HarlinFrancisco/Harlin_Francisco_Electiva_2026_C1/PLC nizao/Proceso de diseño del PLC/Croquis 2.0.jpeg

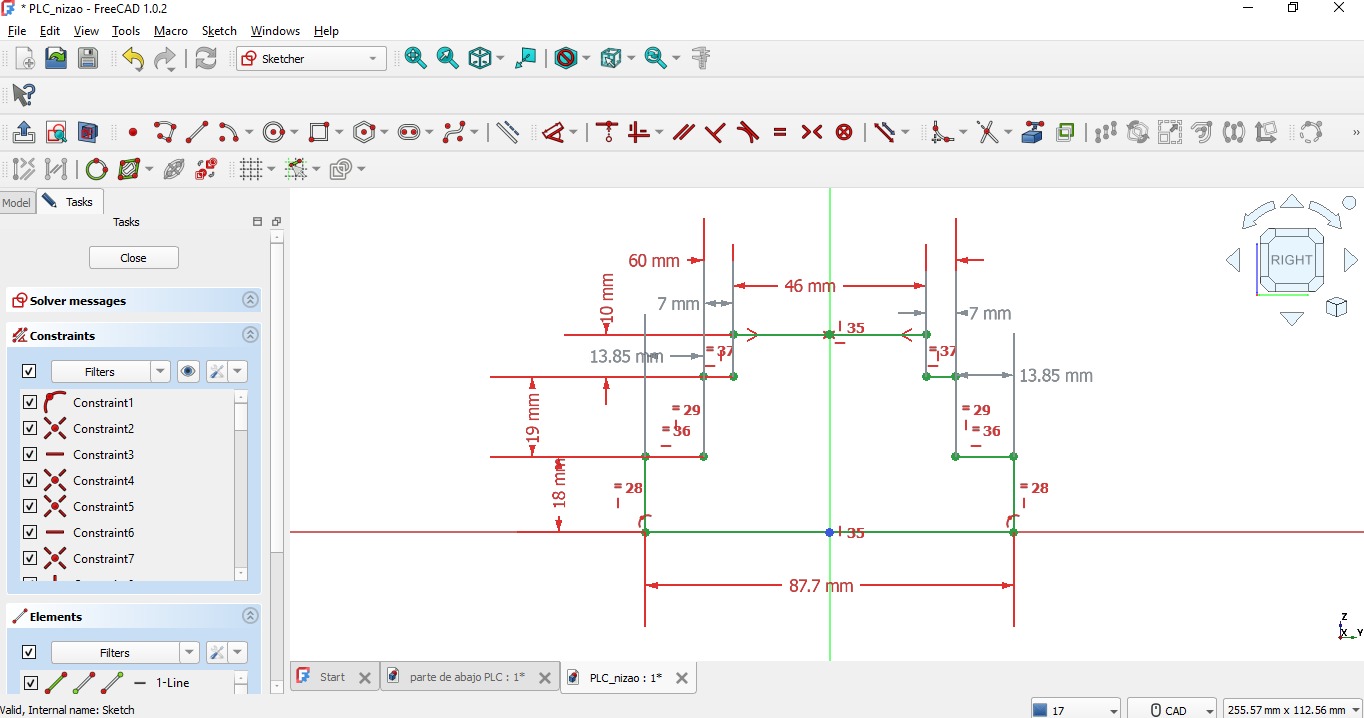
PLC nizao/Proceso de diseño del PLC/Croquis 2.0.jpeg
