HarlinFrancisco/Harlin_Francisco_Electiva_2026_C1/PLC nizao/Proceso de diseño del PLC/Croquis parte 3.jpeg

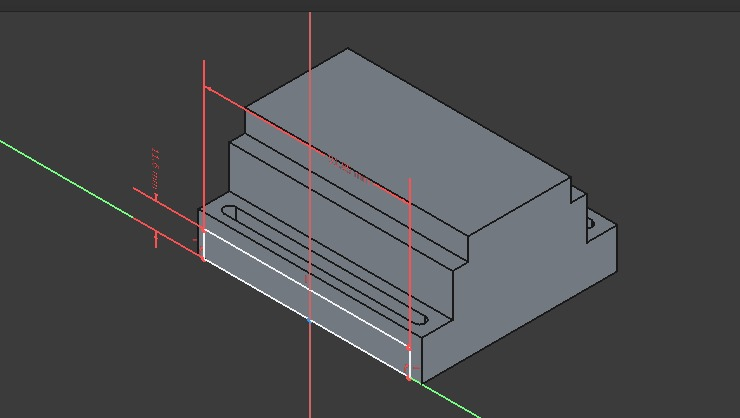
PLC nizao/Proceso de diseño del PLC/Croquis parte 3.jpeg
