HarlinFrancisco/Harlin_Francisco_Electiva_2026_C1/PLC nizao/Proceso de diseño del PLC/Tapa inferior terminada 2.jpeg

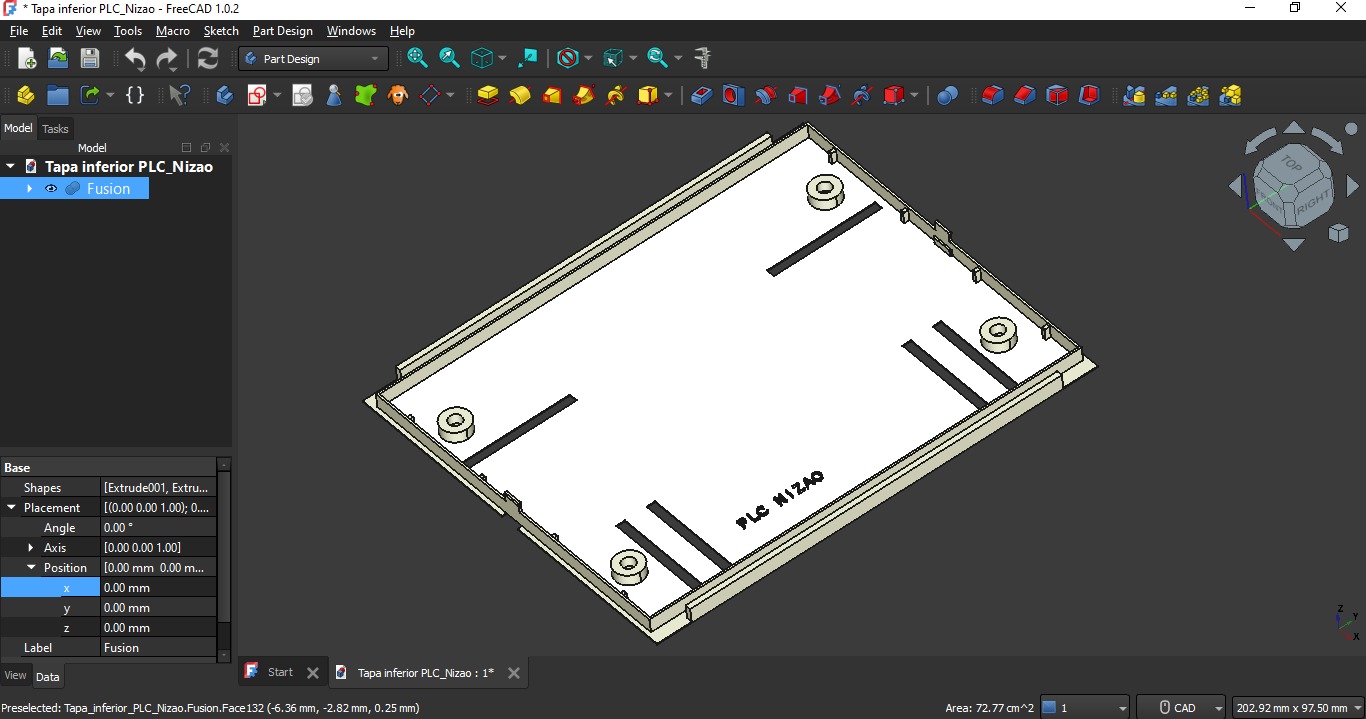
PLC nizao/Proceso de diseño del PLC/Tapa inferior terminada 2.jpeg
