HarlinFrancisco/Harlin_Francisco_Electiva_2026_C1/PLC nizao/Proceso de diseño del PLC/Tapa superior grabado de nombre.jpeg

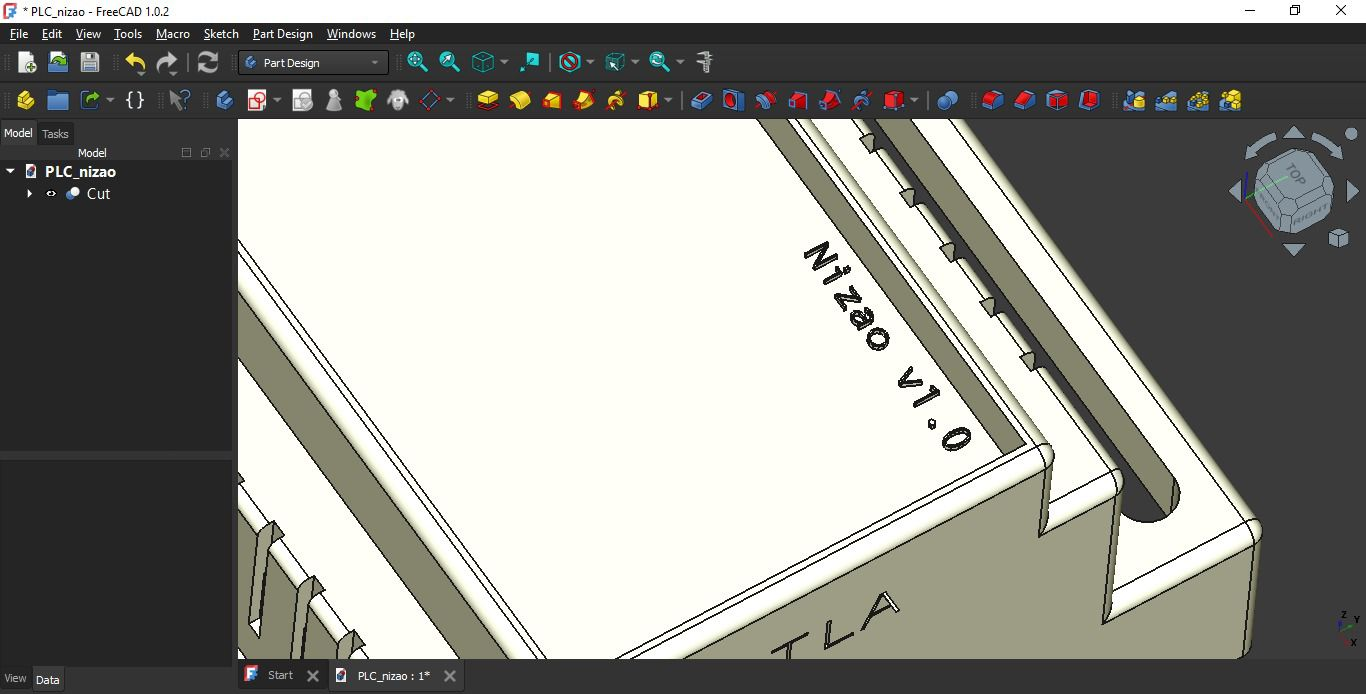
PLC nizao/Proceso de diseño del PLC/Tapa superior grabado de nombre.jpeg
