HarlinFrancisco/Harlin_Francisco_Electiva_2026_C1/PLC nizao/Proceso de diseño del PLC/Tapa superior terminada.jpeg

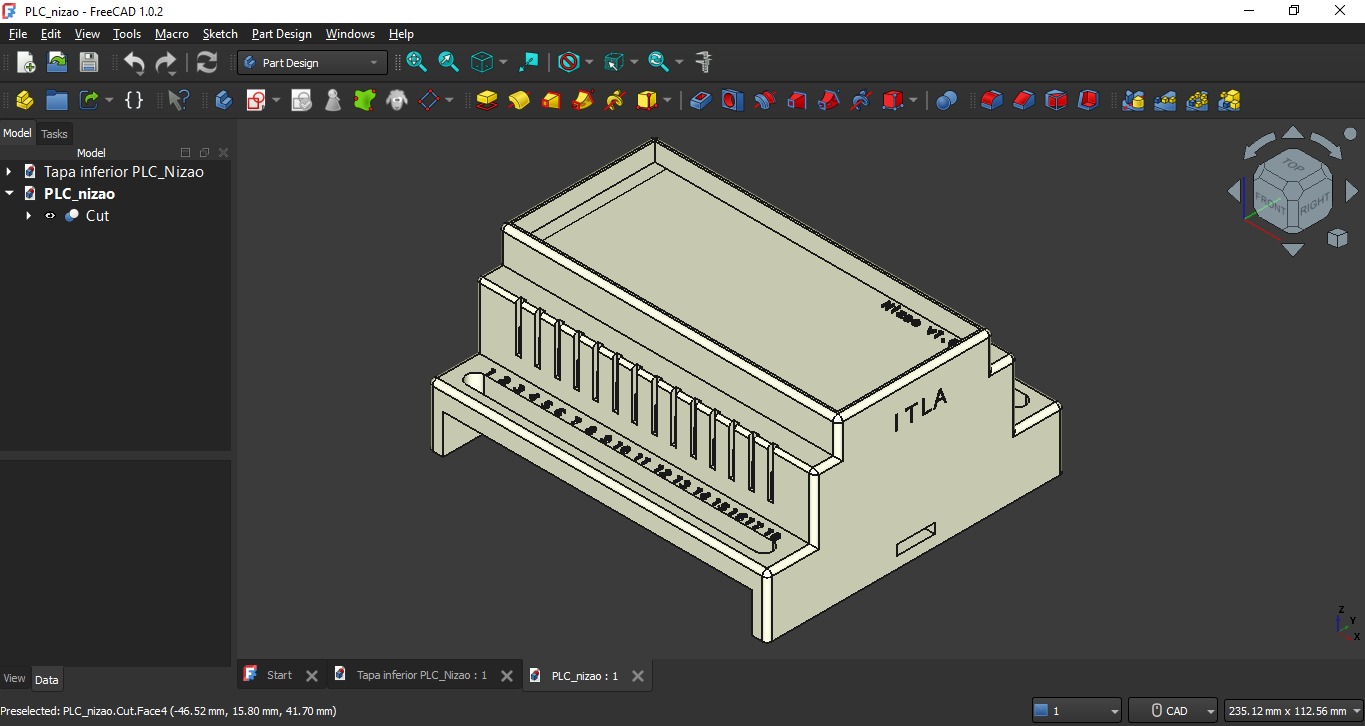
PLC nizao/Proceso de diseño del PLC/Tapa superior terminada.jpeg
