HarlinFrancisco/Harlin_Francisco_Electiva_2026_C1/PLC nizao/Resumenes/Resumen MBSE/MBSE ejemplo.jpg

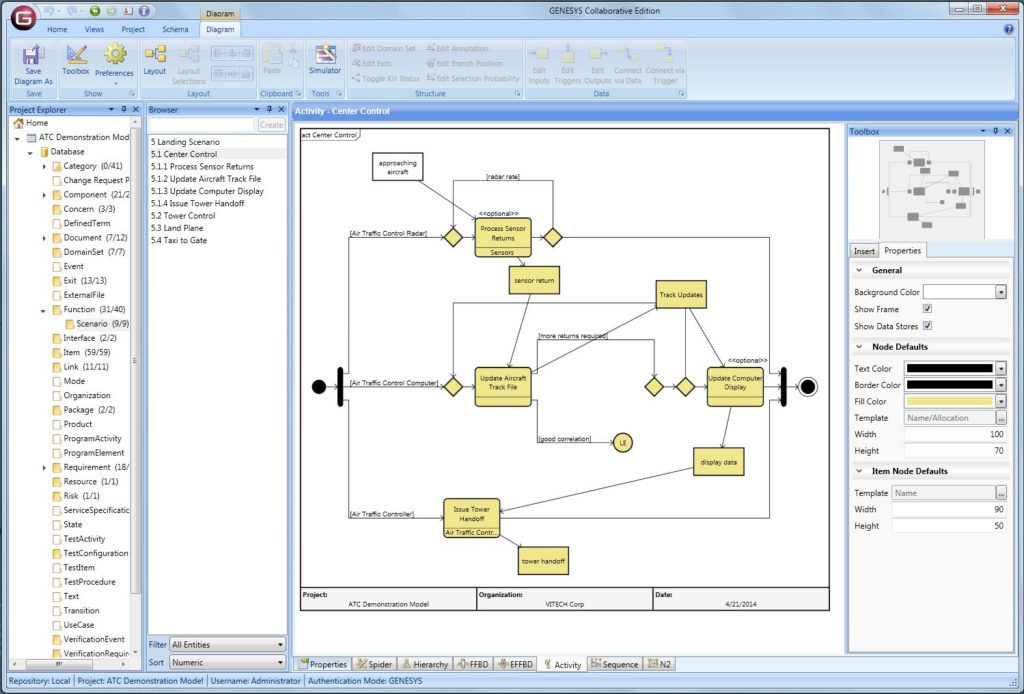
PLC nizao/Resumenes/Resumen MBSE/MBSE ejemplo.jpg
