HarlinFrancisco/Harlin_Francisco_Electiva_2026_C1/PLC nizao/Resumenes/Resumen MBSE/Resumen del MBSE.jpeg

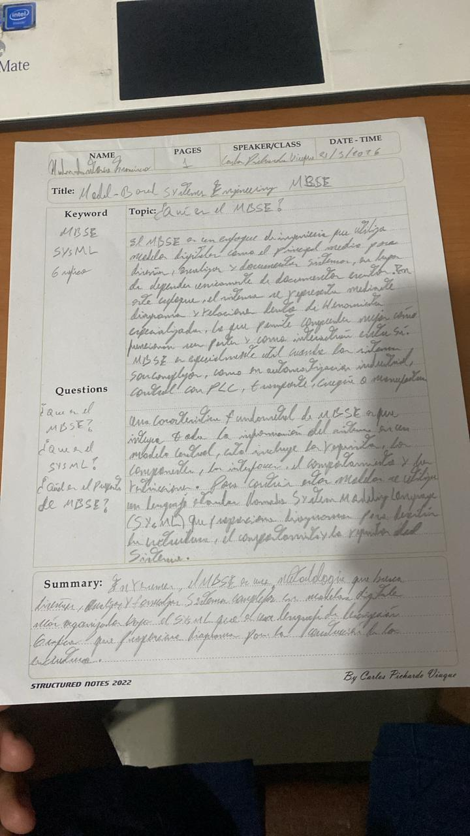
PLC nizao/Resumenes/Resumen MBSE/Resumen del MBSE.jpeg
