HarlinFrancisco/Harlin_Francisco_Electiva_2026_C1/PLC nizao/Archivos de diseño/Case diseño/parte de abajo PLC.FCStd

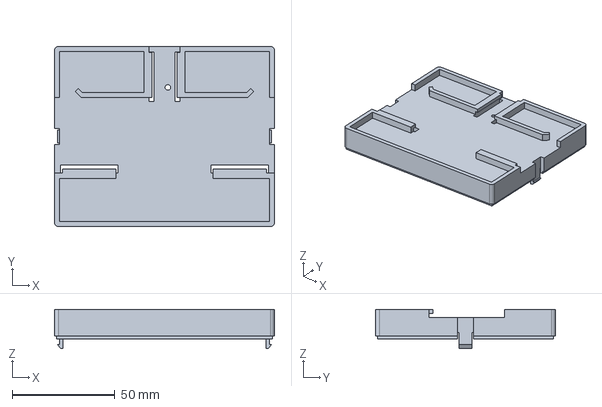
[picture p22: CAD file, 2026-03-19]
PLC nizao/Archivos de diseño/Case diseño/parte de abajo PLC.FCStd
107.0 x 87.7 x 19.1 mm
