HarlinFrancisco/Harlin_Francisco_Electiva_2026_C1/PLC nizao/Archivos de diseño/PCB diseño 3D/PLC4UNI_MEZZANINE_PCB4.FCStd

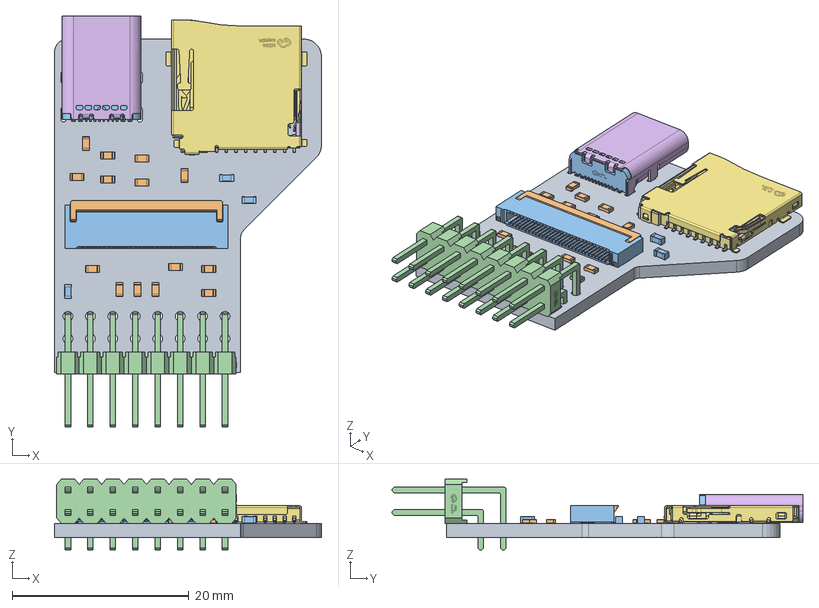
[picture p23: CAD file, 2026-03-21]
PLC nizao/Archivos de diseño/PCB diseño 3D/PLC4UNI_MEZZANINE_PCB4.FCStd
30.2 x 46.5 x 8.00 mm
Pcb_5694
R10_R_0603_1608Metric_17d7d2dbb239 x 14
C1_C_0603_1608Metric_62ff05b13e5a x 3
FPC-SMD_30P-P0.50_FPC-05FB-30PH20
FPC-SMD_30P-P0.50_FPC-05FB-30PH021
FPC-SMD_30P-P0.50_FPC-05FB-30PH022
FPC-SMD_30P-P0.50_FPC-05FB-30PH023
FPC-SMD_30P-P0.50_FPC-05FB-30PH024
FPC-SMD_30P-P0.50_FPC-05FB-30PH025
FPC-SMD_30P-P0.50_FPC-05FB-30PH026
FPC-SMD_30P-P0.50_FPC-05FB-30PH027
FPC-SMD_30P-P0.50_FPC-05FB-30PH028
FPC-SMD_30P-P0.50_FPC-05FB-30PH029
FPC-SMD_30P-P0.50_FPC-05FB-30PH030
FPC-SMD_30P-P0.50_FPC-05FB-30PH031
FPC-SMD_30P-P0.50_FPC-05FB-30PH032
FPC-SMD_30P-P0.50_FPC-05FB-30PH033
FPC-SMD_30P-P0.50_FPC-05FB-30PH034
FPC-SMD_30P-P0.50_FPC-05FB-30PH035
FPC-SMD_30P-P0.50_FPC-05FB-30PH036
FPC-SMD_30P-P0.50_FPC-05FB-30PH037
FPC-SMD_30P-P0.50_FPC-05FB-30PH038
FPC-SMD_30P-P0.50_FPC-05FB-30PH039
FPC-SMD_30P-P0.50_FPC-05FB-30PH040
FPC-SMD_30P-P0.50_FPC-05FB-30PH041
FPC-SMD_30P-P0.50_FPC-05FB-30PH042
FPC-SMD_30P-P0.50_FPC-05FB-30PH043
FPC-SMD_30P-P0.50_FPC-05FB-30PH044
FPC-SMD_30P-P0.50_FPC-05FB-30PH045
FPC-SMD_30P-P0.50_FPC-05FB-30PH046
FPC-SMD_30P-P0.50_FPC-05FB-30PH047
FPC-SMD_30P-P0.50_FPC-05FB-30PH048
FPC-SMD_30P-P0.50_FPC-05FB-30PH049
FPC-SMD_30P-P0.50_FPC-05FB-30PH050
FPC-SMD_30P-P0.50_FPC-05FB-30PH051
FPC-SMD_30P-P0.50_FPC-05FB-30PH052
FPC-SMD_30P-P0.50_FPC-05FB-30PH053
FPC-SMD_30P-P0.50_FPC-05FB-30PH054
FPC-SMD_30P-P0.50_FPC-05FB-30PH055
FPC-SMD_30P-P0.50_FPC-05FB-30PH056
FPC-SMD_30P-P0.50_FPC-05FB-30PH057
FPC-SMD_30P-P0.50_FPC-05FB-30PH058
FPC-SMD_30P-P0.50_FPC-05FB-30PH059
FPC-SMD_30P-P0.50_FPC-05FB-30PH060
FPC-SMD_30P-P0.50_FPC-05FB-30PH061
FPC-SMD_30P-P0.50_FPC-05FB-30PH062
FPC-SMD_30P-P0.50_FPC-05FB-30PH063
FPC-SMD_30P-P0.50_FPC-05FB-30PH064
FPC-SMD_30P-P0.50_FPC-05FB-30PH065
FPC-SMD_30P-P0.50_FPC-05FB-30PH066
FPC-SMD_30P-P0.50_FPC-05FB-30PH067
FPC-SMD_30P-P0.50_FPC-05FB-30PH068
FPC-SMD_30P-P0.50_FPC-05FB-30PH069
FPC-SMD_30P-P0.50_FPC-05FB-30PH070
FPC-SMD_30P-P0.50_FPC-05FB-30PH071
FPC-SMD_30P-P0.50_FPC-05FB-30PH072
FPC-SMD_30P-P0.50_FPC-05FB-30PH073
FPC-SMD_30P-P0.50_FPC-05FB-30PH074
FPC-SMD_30P-P0.50_FPC-05FB-30PH075
FPC-SMD_30P-P0.50_FPC-05FB-30PH076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
