HarlinFrancisco/Harlin_Francisco_Electiva_2026_C1/PLC nizao/Archivos de diseño/Case diseño/PLC_nizao.FCStd

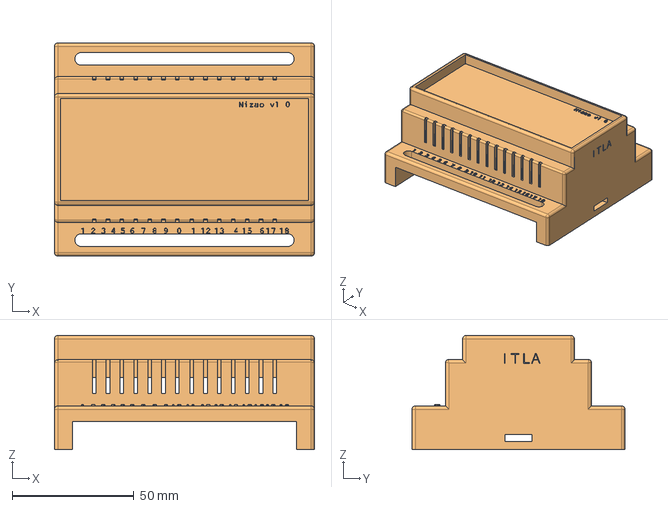
[picture p24: CAD file, 2026-03-19]
PLC nizao/Archivos de diseño/Case diseño/PLC_nizao.FCStd
107.0 x 87.7 x 47.0 mm
