HarlinFrancisco/Harlin_Francisco_Electiva_2026_C1/PLC nizao/Archivos de diseño/PCB diseño 3D/PLC4UNI-GC2.FCStd

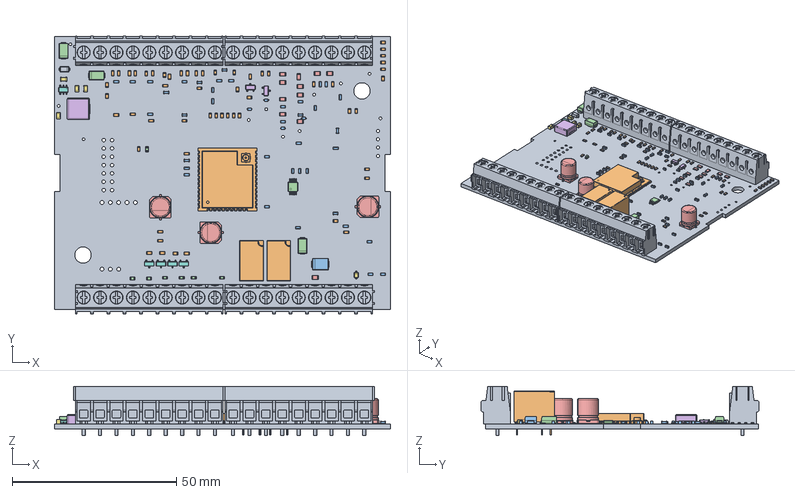
[picture p26: CAD file, 2026-03-19]
PLC nizao/Archivos de diseño/PCB diseño 3D/PLC4UNI-GC2.FCStd
102.4 x 84.7 x 15.0 mm
Pcb_972f
R19_R_0603_1608Metric_95023bde066c x 55
C35_C_0603_1608Metric_47b13ffb3005 x 38
LED6_LED_0603_1608Metric_29318ab0fcab x 7
R48_R_0805_2012Metric_8760a1cc7825 x 11
L1_L_APV_APH0630_de9836e3420d
C42_C_0805_2012Metric_19c76a4cbd61 x 4
Q5_SOT-23-3_755230199891 x 4
connector-up1_TerminalBlock_Phoenix_PT_15_9_50_H_1x09_P500mm_Horizontal_d1ef8af655aa x 4
K2_Relay_SPDT_Omron_G5V-1_184c7eb9dbbd x 2
D16_D_SOD_523_72fd29d7aec3 x 4
D1_D_SMA_a7c1ce363bb1 x 3
C41_CP_Elec_63x77_8b15a8016627 x 3
D13_SOT-23_26e4d9a6c13a x 2
D8_D_SOD-323_9eebc493203e
U3_TSOT-23-6_46dad00178f7
D6_D_SOD_123F_e5456ec5de3d
U1_ESP32-WROOM-32U_f9fd82e02a48[2]
D5_D_SMB_57d549242c6f
U10_TSSOP-10_3x3mm_P0.5mm_bae4eb107ac5
