HarlinFrancisco/Harlin_Francisco_Electiva_2026_C1/PLC nizao/Archivos de diseño/Case diseño/Tapa inferior PLC_Nizao.FCStd

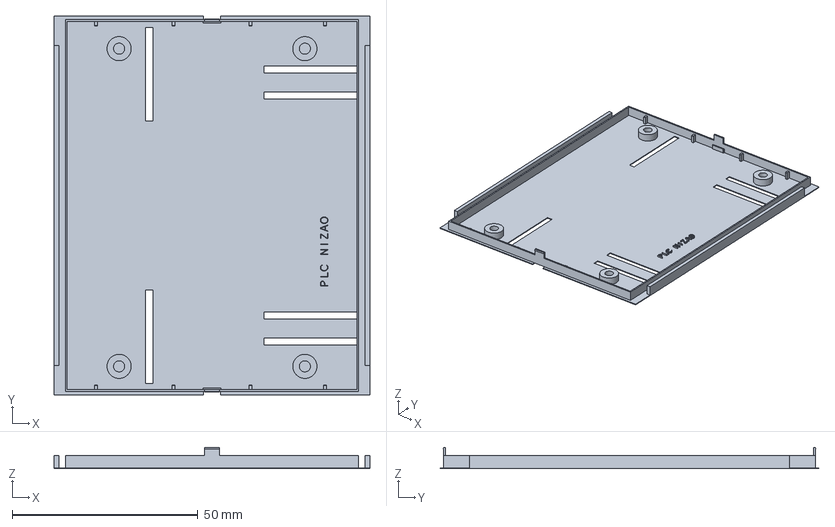
[picture p27: CAD file, 2026-02-17]
PLC nizao/Archivos de diseño/Case diseño/Tapa inferior PLC_Nizao.FCStd
85.0 x 102.0 x 5.75 mm
