HarlinFrancisco/Harlin_Francisco_Electiva_2026_C1/(list of files, cad)

Other CAD files:
PLC nizao/Archivos de diseño/Case diseño/PLC nizao assembly.FCStd
