HarlinFrancisco/Harlin_Francisco_Electiva_2026_C1/PLC nizao/Proceso de diseño del PLC/Proceso de ensamblaje.jpeg

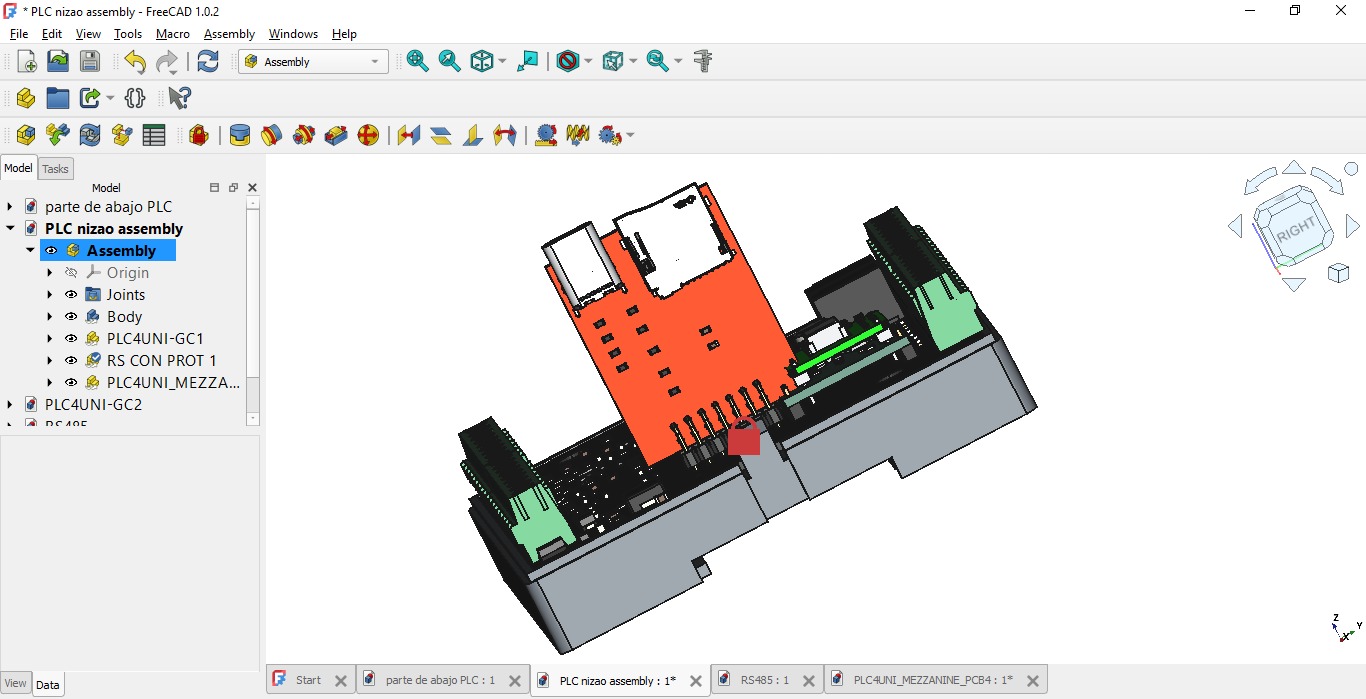
PLC nizao/Proceso de diseño del PLC/Proceso de ensamblaje.jpeg
