HarlinFrancisco/Harlin_Francisco_Electiva_2026_C1/PLC nizao/Circuitos Kicad/PLC4unit/PLC4UNI-GC1.kicad_pcb

## KiCad design PLC nizao/Circuitos Kicad/PLC4unit/PLC4UNI-GC1.kicad_pcb (2026-03-19)

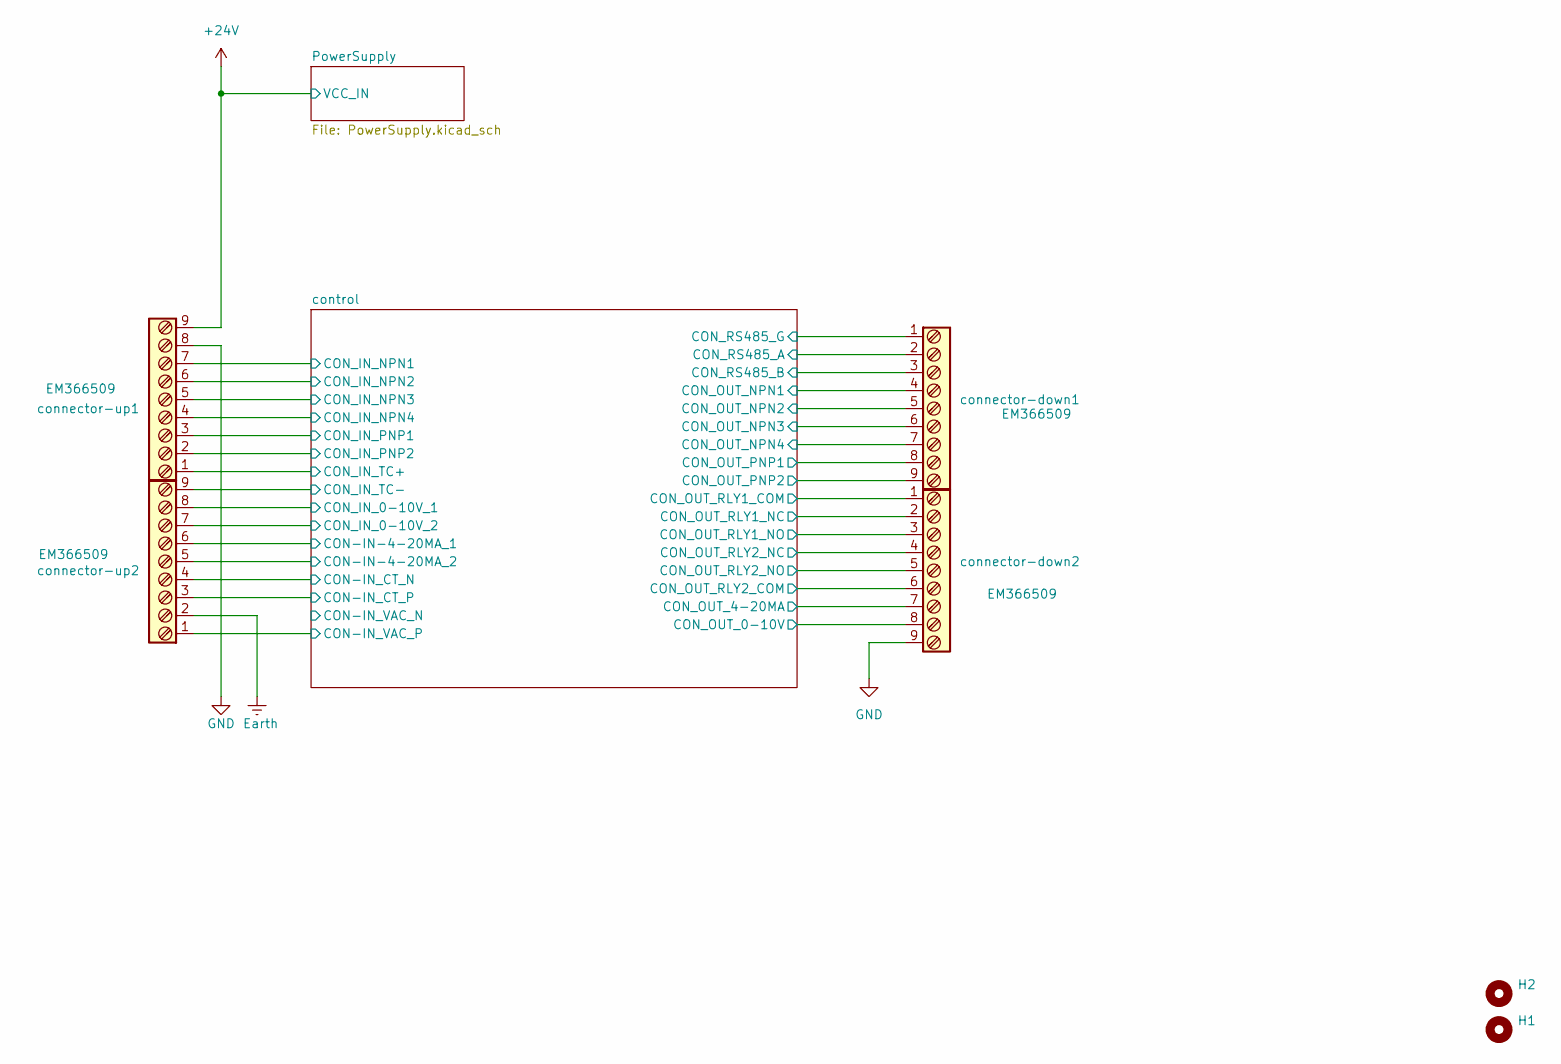
[picture p33: schematic PLC4UNI-GC1.kicad_sch]

Parts:
H1, H2: MountingHole; MountingHole_3.2mm_M3
connector-down1, connector-down2: Screw_Terminal_9_P5.00mm; TerminalBlock_Phoenix_PT-1,5-9-5.0-H_1x09_P5.00mm_Horizontal; Part number EM366509
connector-up1, connector-up2: Screw_Terminal_9_P5.00mm; TerminalBlock_Phoenix_PT-1,5-9-5.0-H_1x09_P5.00mm_Horizontal; Part number EM366509

Connections:
+24V: connector-up1.9; also elsewhere on the board
/control/CON-IN-4-20MA_1: connector-up2.6; also elsewhere on the board
/control/CON-IN-4-20MA_2: connector-up2.5; also elsewhere on the board
/control/CON-IN_CT_N: connector-up2.4; also elsewhere on the board
/control/CON-IN_CT_P: connector-up2.3; also elsewhere on the board
/control/CON-IN_VAC_P: connector-up2.1; also elsewhere on the board
/control/CON_IN_0-10V_1: connector-up2.8; also elsewhere on the board
/control/CON_IN_0-10V_2: connector-up2.7; also elsewhere on the board
/control/CON_IN_NPN1: connector-up1.7; also elsewhere on the board
/control/CON_IN_NPN2: connector-up1.6; also elsewhere on the board
/control/CON_IN_NPN3: connector-up1.5; also elsewhere on the board
/control/CON_IN_NPN4: connector-up1.4; also elsewhere on the board
/control/CON_IN_PNP1: connector-up1.3; also elsewhere on the board
/control/CON_IN_PNP2: connector-up1.2; also elsewhere on the board
/control/CON_IN_TC+: connector-up1.1; also elsewhere on the board
/control/CON_IN_TC-: connector-up2.9; also elsewhere on the board
/control/CON_OUT_0-10V: connector-down2.8; also elsewhere on the board
/control/CON_OUT_4-20MA: connector-down2.7; also elsewhere on the board
/control/CON_OUT_NPN1: connector-down1.4; also elsewhere on the board
/control/CON_OUT_NPN2: connector-down1.5; also elsewhere on the board
/control/CON_OUT_NPN3: connector-down1.6; also elsewhere on the board
/control/CON_OUT_NPN4: connector-down1.7; also elsewhere on the board
/control/CON_OUT_PNP1: connector-down1.8; also elsewhere on the board
/control/CON_OUT_PNP2: connector-down1.9; also elsewhere on the board
/control/CON_OUT_RLY1_COM: connector-down2.1; also elsewhere on the board
/control/CON_OUT_RLY1_NC: connector-down2.2; also elsewhere on the board
/control/CON_OUT_RLY1_NO: connector-down2.3; also elsewhere on the board
/control/CON_OUT_RLY2_COM: connector-down2.6; also elsewhere on the board
/control/CON_OUT_RLY2_NC: connector-down2.4; also elsewhere on the board
/control/CON_OUT_RLY2_NO: connector-down2.5; also elsewhere on the board
/control/CON_RS485_A: connector-down1.2; also elsewhere on the board
/control/CON_RS485_B: connector-down1.3; also elsewhere on the board
/control/CON_RS485_G: connector-down1.1; also elsewhere on the board
Earth: connector-up2.2; also elsewhere on the board
GND: connector-down2.9, connector-up1.8; also elsewhere on the board

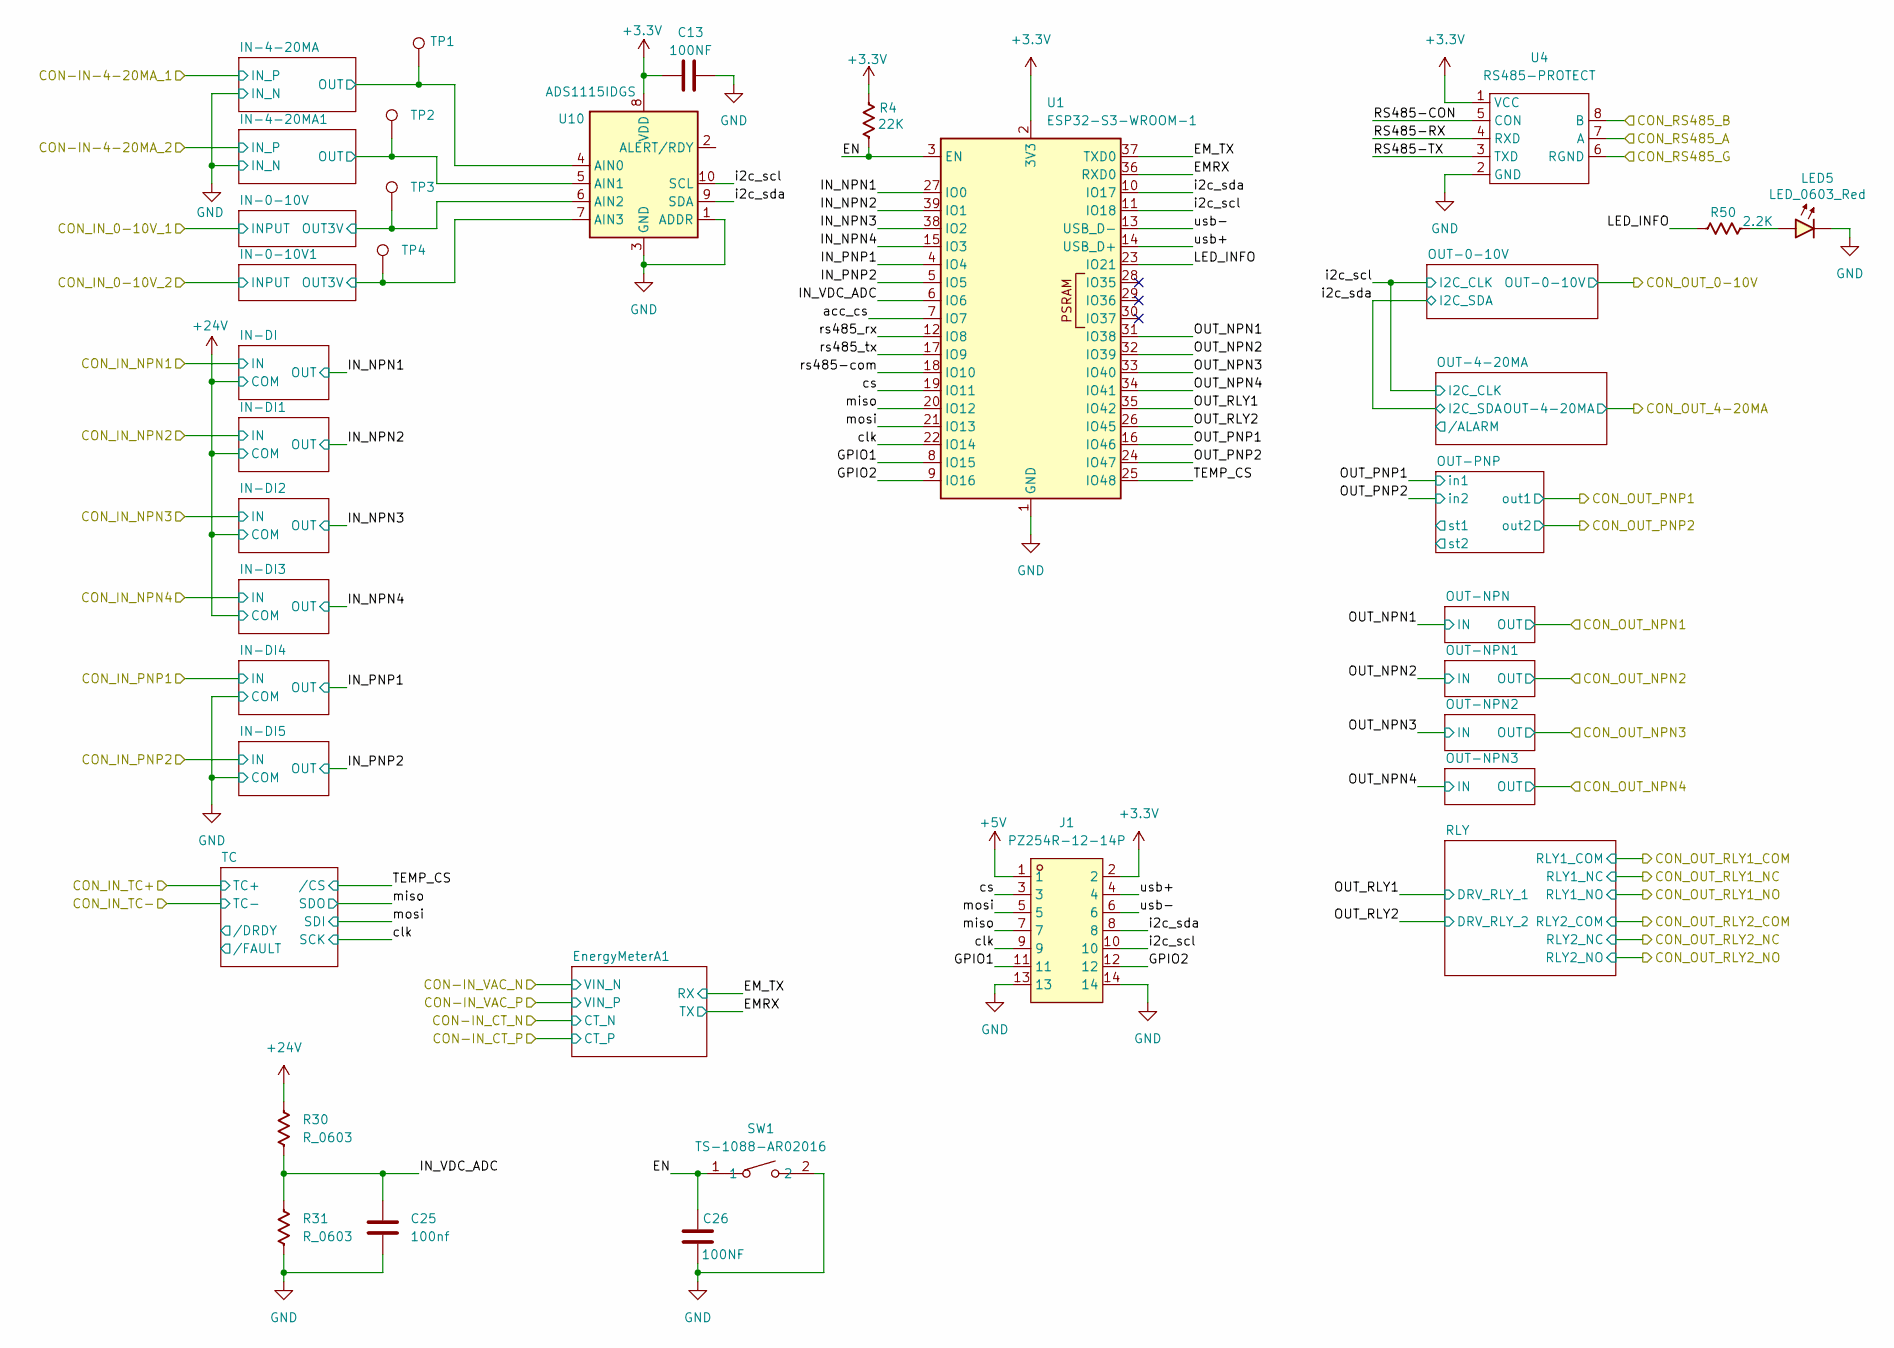
[picture p34: schematic control.kicad_sch]

Parts:
C13, C26: 100NF; C_0603_1608Metric
C25: 100nf; C_0603_1608Metric
J1: PZ254R-12-14P; HDR-TH_14P-P2.54-H-M-R2-C7-S2.54; LCSC Part C492435
LED5: LED_0603_Red; LED_0603_1608Metric
R4: 22K; R_0603_1608Metric
R30, R31: R_0603; R_0603_1608Metric
R50: 2.2K; R_0603_1608Metric
SW1: TS-1088-AR02016; SW-SMD_L3.9-W3.0-P4.45; LCSC Part C720477
TP1, TP2, TP3, TP4: TestPoint_Hole1; TestPoint_WireHole
U1: ESP32-S3-WROOM-1; ESP32-S3-WROOM-1U
U4: RS485-PROTECT; RS-485-PROTECT; Part Number RS-485-PROTECT
U10: ADS1115IDGS; TSSOP-10_3x3mm_P0.5mm

Connections:
+3.3V: C13.1, J1.2, R4.2, U1.2 (3V3), U4.1 (VCC), U10.8 (VDD); also elsewhere on the board
+5V: J1.1; also elsewhere on the board
+24V: R30.1; also elsewhere on the board
/control/CON_RS485_A: U4.7 (A); also elsewhere on the board
/control/CON_RS485_B: U4.8 (B); also elsewhere on the board
/control/CON_RS485_G: U4.6 (RGND); also elsewhere on the board
/control/EMRX: U1.36 (RXD0); also elsewhere on the board
/control/EM_TX: U1.37 (TXD0); also elsewhere on the board
/control/EN: C26.2, R4.1, SW1.1, U1.3 (EN)
/control/GPIO1: J1.11, U1.8 (IO15)
/control/GPIO2: J1.12, U1.9 (IO16)
/control/IN-0-10V1/OUT3V: TP4.1, U10.7 (AIN3); also elsewhere on the board
/control/IN-0-10V/OUT3V: TP3.1, U10.6 (AIN2); also elsewhere on the board
/control/IN-4-20MA1/OUT: TP2.1, U10.5 (AIN1); also elsewhere on the board
/control/IN-4-20MA/OUT: TP1.1, U10.4 (AIN0); also elsewhere on the board
/control/IN_NPN1: U1.27 (IO0); also elsewhere on the board
/control/IN_NPN2: U1.39 (IO1); also elsewhere on the board
/control/IN_NPN3: U1.38 (IO2); also elsewhere on the board
/control/IN_NPN4: U1.15 (IO3); also elsewhere on the board
/control/IN_PNP1: U1.4 (IO4); also elsewhere on the board
/control/IN_PNP2: U1.5 (IO5); also elsewhere on the board
/control/IN_VDC_ADC: C25.1, R30.2, R31.1, U1.6 (IO6)
/control/LED_INFO: R50.2, U1.23 (IO21)
/control/OUT_NPN1: U1.31 (IO38); also elsewhere on the board
/control/OUT_NPN2: U1.32 (IO39); also elsewhere on the board
/control/OUT_NPN3: U1.33 (IO40); also elsewhere on the board
/control/OUT_NPN4: U1.34 (IO41); also elsewhere on the board
/control/OUT_PNP1: U1.16 (IO46); also elsewhere on the board
/control/OUT_PNP2: U1.24 (IO47); also elsewhere on the board
/control/OUT_RLY1: U1.35 (IO42); also elsewhere on the board
/control/OUT_RLY2: U1.26 (IO45); also elsewhere on the board
/control/RS485-CON: U4.5 (CON)
/control/RS485-RX: U4.4 (RXD)
/control/RS485-TX: U4.3 (TXD)
/control/TEMP_CS: U1.25 (IO48); also elsewhere on the board
/control/acc_cs: U1.7 (IO7)
/control/clk: J1.9, U1.22 (IO14); also elsewhere on the board
/control/cs: J1.3, U1.19 (IO11)
/control/i2c_scl: J1.10, U1.11 (IO18), U10.10 (SCL); also elsewhere on the board
/control/i2c_sda: J1.8, U1.10 (IO17), U10.9 (SDA); also elsewhere on the board
/control/miso: J1.7, U1.20 (IO12); also elsewhere on the board
/control/mosi: J1.5, U1.21 (IO13); also elsewhere on the board
/control/rs485-com: U1.18 (IO10)
/control/rs485_rx: U1.12 (IO8)
/control/rs485_tx: U1.17 (IO9)
/control/usb+: J1.4, U1.14 (USB_D+)
/control/usb-: J1.6, U1.13 (USB_D-)
GND: C13.2, C25.2, C26.1, J1.13, J1.14, LED5.1 (K), R31.2, SW1.2, U1.1 (GND), U1.40 (GND), U1.41 (GND), U4.2 (GND), U10.1 (ADDR), U10.3 (GND); also elsewhere on the board
unnamed: LED5.2 (A), R50.1

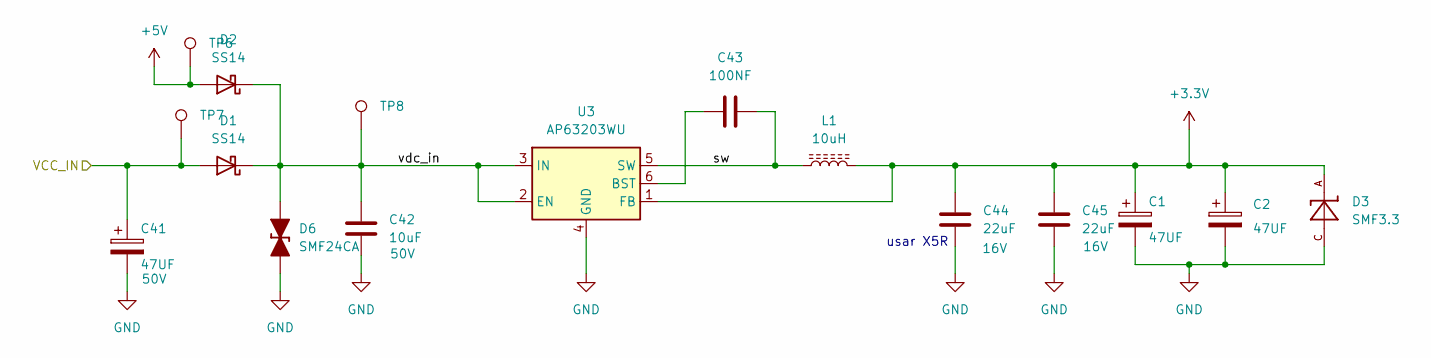
[picture p35: schematic PowerSupply.kicad_sch]

Parts:
C1, C2: 47UF; CP_Elec_6.3x7.7; Part Number UUD1C470MCL1GS
C41: 47UF; CP_Elec_6.3x7.7; Part Number C2887275; LCSC Part C2887275
C42: 10uF; C_0805_2012Metric; Part Number GRM21BR61H106KE43L; LCSC Part C440198
C43: 100NF; C_0805_2012Metric; Part Number CC0805KRX7R9BB104; LCSC Part C49678
C44, C45: 22uF; C_0805_2012Metric; Part Number CL21A226MOQNNNE; LCSC Part C98190
D1, D2: SS14; D_SMA
D3: SMF3.3; SMF3.3_SODFL3718X108N
D6: SMF24CA; D_SOD-123F
L1: 10uH; L_APV_APH0630; Part Number SL0630-100M; LCSC Part C22463823
TP6, TP7, TP8: TestPoint_Hole1; TestPoint_WireHole
U3: AP63203WU; TSOT-23-6

Connections:
+3.3V: C1.1, C2.1, C44.1, C45.1, D3.A, L1.2, U3.1 (FB); also elsewhere on the board
+5V: D2.2 (A), TP6.1; also elsewhere on the board
+24V: C41.1, D1.2 (A), TP7.1; also elsewhere on the board
/PowerSupply/sw: C43.2, L1.1, U3.5 (SW)
/PowerSupply/vdc_in: C42.1, D1.1 (K), D2.1 (K), D6.2 (A), TP8.1, U3.2 (EN), U3.3 (IN)
GND: C1.2, C2.2, C41.2, C42.2, C44.2, C45.2, D3.C, D6.1 (K), U3.4 (GND); also elsewhere on the board
unnamed: C43.1, U3.6 (BST)

Notes on the sheet:
usar X5R

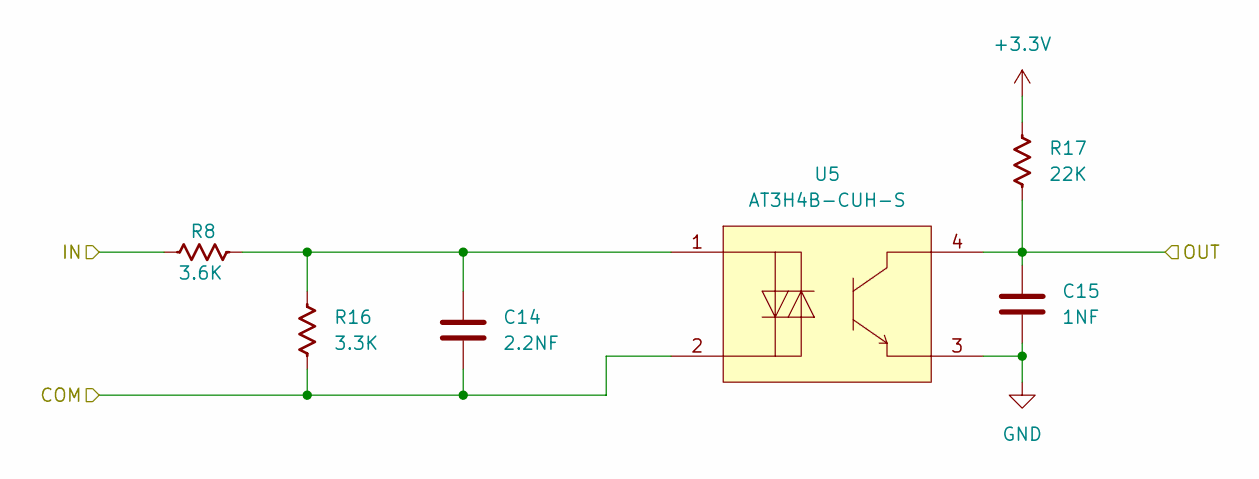
[picture p36: schematic IN-DI.kicad_sch]

Parts:
C14: 2.2NF; C_0603_1608Metric
C15: 1NF; C_0603_1608Metric
R8: 3.6K; R_0603_1608Metric
R16: 3.3K; R_0603_1608Metric
R17: 22K; R_0603_1608Metric
U5: AT3H4B-CUH-S; SSOP-4_L2.7-W4.6-P1.27-LS7.0-TL; LCSC Part C20612635

Connections:
+3.3V: R17.2; also elsewhere on the board
+24V: C14.2, R16.1, U5.2; also elsewhere on the board
/control/CON_IN_NPN2: R8.1; also elsewhere on the board
/control/IN_NPN2: C15.1, R17.1, U5.4; also elsewhere on the board
GND: C15.2, U5.3; also elsewhere on the board
unnamed: C14.1, R8.2, R16.2, U5.1

Parts of its further copies:
C3, C4, C16, C18, C21: 2.2NF; C_0603_1608Metric
C9, C17, C19, C20, C22: 1NF; C_0603_1608Metric
R1, R5, R18, R21, R24: 3.6K; R_0603_1608Metric
R2, R6, R19, R22, R25: 3.3K; R_0603_1608Metric
R3, R7, R20, R23, R26: 22K; R_0603_1608Metric
U2, U6, U11, U12, U14: AT3H4B-CUH-S; SSOP-4_L2.7-W4.6-P1.27-LS7.0-TL; LCSC Part C20612635

Connections of its further copies:
+3.3V: R3.2, R7.2, R20.2, R23.2, R26.2; also elsewhere on the board
+24V: C4.2, C16.2, C18.2, R6.1, R19.1, R22.1, U2.2, U11.2, U12.2; also elsewhere on the board
/control/CON_IN_NPN1: R5.1; also elsewhere on the board
/control/CON_IN_NPN3: R18.1; also elsewhere on the board
/control/CON_IN_NPN4: R21.1; also elsewhere on the board
/control/CON_IN_PNP1: R1.1; also elsewhere on the board
/control/CON_IN_PNP2: R24.1; also elsewhere on the board
/control/IN_NPN1: C9.1, R7.1, U2.4; also elsewhere on the board
/control/IN_NPN3: C17.1, R20.1, U11.4; also elsewhere on the board
/control/IN_NPN4: C19.1, R23.1, U12.4; also elsewhere on the board
/control/IN_PNP1: C20.1, R3.1, U6.4; also elsewhere on the board
/control/IN_PNP2: C22.1, R26.1, U14.4; also elsewhere on the board
GND: C3.2, C9.2, C17.2, C19.2, C20.2, C21.2, C22.2, R2.1, R25.1, U2.3, U6.2, U6.3, U11.3, U12.3, U14.2, U14.3; also elsewhere on the board
unnamed: C3.1, R1.2, R2.2, U6.1
unnamed: C4.1, R5.2, R6.2, U2.1
unnamed: C16.1, R18.2, R19.2, U11.1
unnamed: C18.1, R21.2, R22.2, U12.1
unnamed: C21.1, R24.2, R25.2, U14.1

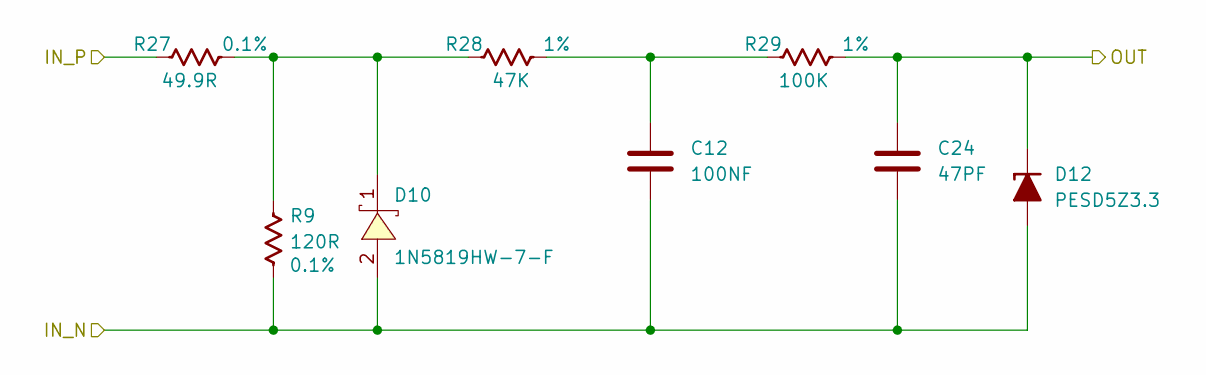
[picture p37: schematic IN-4-20MA.kicad_sch]

Parts:
C12: 100NF; C_0603_1608Metric
C24: 47PF; C_0603_1608Metric
D10: 1N5819HW-7-F; SOD-123_L2.7-W1.6-LS3.7-RD; LCSC Part C82544
D12: PESD5Z3.3; D_SOD-523
R9: 120R; R_0805_2012Metric
R27: 49.9R; R_0805_2012Metric
R28: 47K; R_0805_2012Metric
R29: 100K; R_0805_2012Metric

Connections:
/control/CON-IN-4-20MA_1: R27.2; also elsewhere on the board
/control/IN-4-20MA/OUT: C24.1, D12.1 (K), R29.1; also elsewhere on the board
GND: C12.2, C24.2, D10.2 (A), D12.2 (A), R9.1; also elsewhere on the board
unnamed: C12.1, R28.1, R29.2
unnamed: D10.1 (K), R9.2, R27.1, R28.2

Parts of its further copies:
C33: 100NF; C_0603_1608Metric
C34: 47PF; C_0603_1608Metric
D15: 1N5819HW-7-F; SOD-123_L2.7-W1.6-LS3.7-RD; LCSC Part C82544
D16: PESD5Z3.3; D_SOD-523
R46: 49.9R; R_0805_2012Metric
R47: 120R; R_0805_2012Metric
R48: 47K; R_0805_2012Metric
R49: 100K; R_0805_2012Metric

Connections of its further copies:
/control/CON-IN-4-20MA_2: R46.2; also elsewhere on the board
/control/IN-4-20MA1/OUT: C34.1, D16.1 (K), R49.1; also elsewhere on the board
GND: C33.2, C34.2, D15.2 (A), D16.2 (A), R47.1; also elsewhere on the board
unnamed: C33.1, R48.1, R49.2
unnamed: D15.1 (K), R46.1, R47.2, R48.2

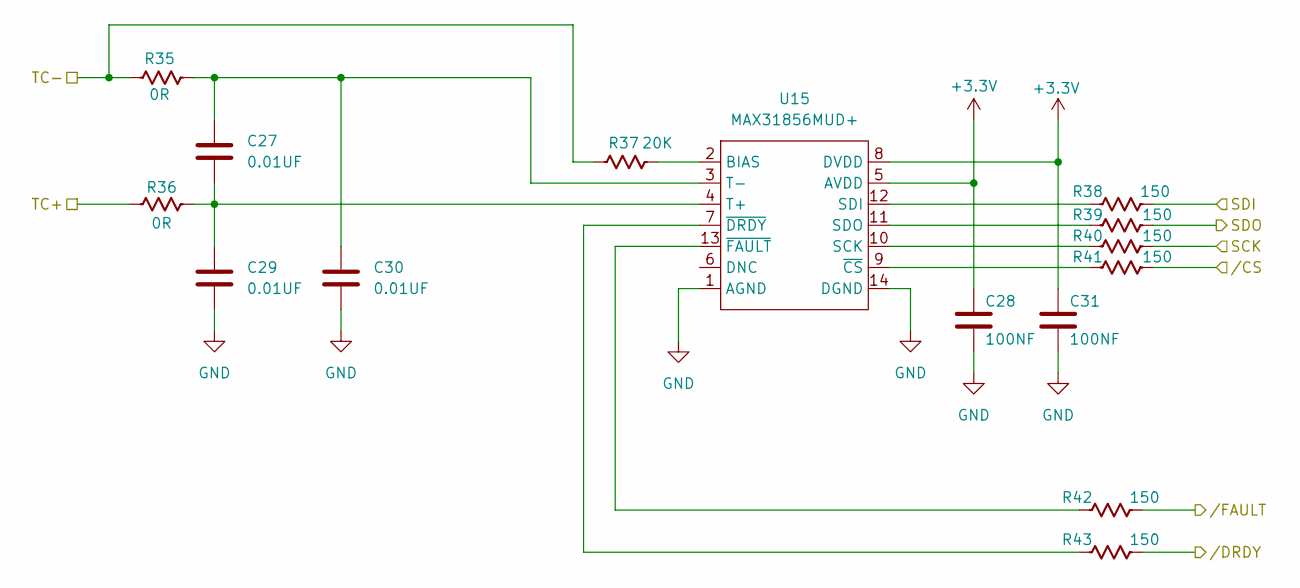
[picture p38: schematic TC.kicad_sch]

Parts:
C27, C29, C30: 0.01UF; C_0603_1608Metric
C28, C31: 100NF; C_0603_1608Metric
R35, R36: 0R; R_0603_1608Metric
R37: 20K; R_0603_1608Metric
R38, R39, R40, R41, R42, R43: 150; R_0603_1608Metric
U15: MAX31856MUD+; TSSOP-14_L5.0-W4.4-P0.65-LS6.4-BL; LCSC Part C116632

Connections:
+3.3V: C28.1, C31.1, U15.5 (AVDD), U15.8 (DVDD); also elsewhere on the board
/control/CON_IN_TC+: R36.1; also elsewhere on the board
/control/CON_IN_TC-: R35.1, R37.1; also elsewhere on the board
/control/TC//DRDY: R43.2
/control/TC//FAULT: R42.2
/control/TEMP_CS: R41.2; also elsewhere on the board
/control/clk: R40.2; also elsewhere on the board
/control/miso: R39.2; also elsewhere on the board
/control/mosi: R38.2; also elsewhere on the board
GND: C28.2, C29.2, C30.2, C31.2, U15.1 (AGND), U15.14 (DGND); also elsewhere on the board
unnamed: R37.2, U15.2 (BIAS)
unnamed: R40.1, U15.10 (SCK)
unnamed: R38.1, U15.12 (SDI)
unnamed: R39.1, U15.11 (SDO)
unnamed: C27.2, C29.1, R36.2, U15.4 (T+)
unnamed: C27.1, C30.1, R35.2, U15.3 (T-)
unnamed: R41.1, U15.9 (~CS)
unnamed: R43.1, U15.7 (~DRDY)
unnamed: R42.1, U15.13 (~FAULT)

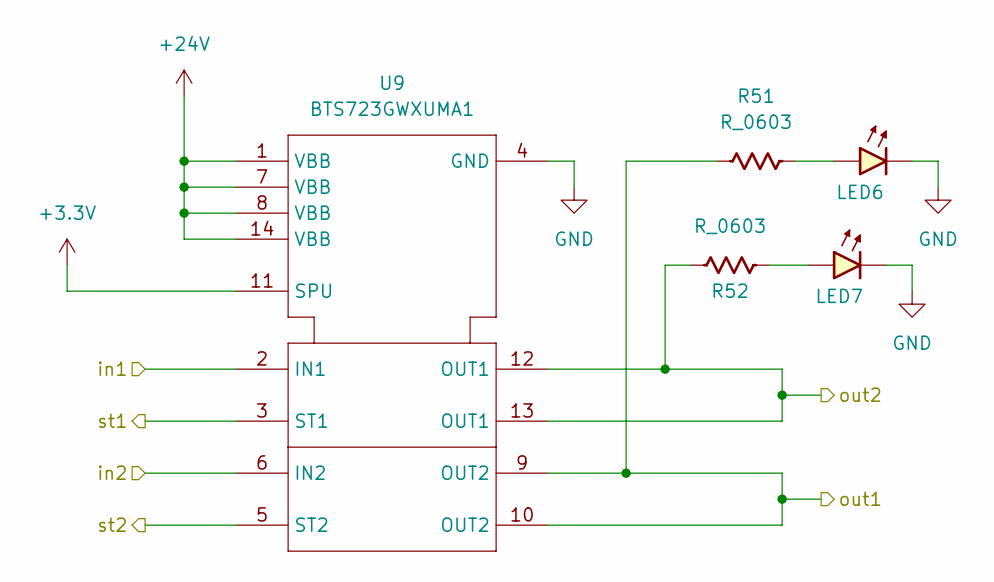
[picture p39: schematic OUT-PNP.kicad_sch]

Parts:
LED6, LED7: LED_0603_Red; LED_0603_1608Metric
R51, R52: R_0603; R_0603_1608Metric
U9: BTS723GWXUMA1; SOIC-14_L8.7-W3.9-P1.27-LS6.0-BL; LCSC Part C67625

Connections:
+3.3V: U9.11 (SPU); also elsewhere on the board
+24V: U9.1 (VBB), U9.7 (VBB), U9.8 (VBB), U9.14 (VBB); also elsewhere on the board
/control/CON_OUT_PNP1: R51.1, U9.9 (OUT2), U9.10 (OUT2); also elsewhere on the board
/control/CON_OUT_PNP2: R52.1, U9.12 (OUT1), U9.13 (OUT1); also elsewhere on the board
/control/OUT-PNP/st1: U9.3 (ST1)
/control/OUT-PNP/st2: U9.5 (ST2)
/control/OUT_PNP1: U9.2 (IN1); also elsewhere on the board
/control/OUT_PNP2: U9.6 (IN2); also elsewhere on the board
GND: LED6.1 (K), LED7.1 (K), U9.4 (GND); also elsewhere on the board
unnamed: LED6.2 (A), R51.2
unnamed: LED7.2 (A), R52.2

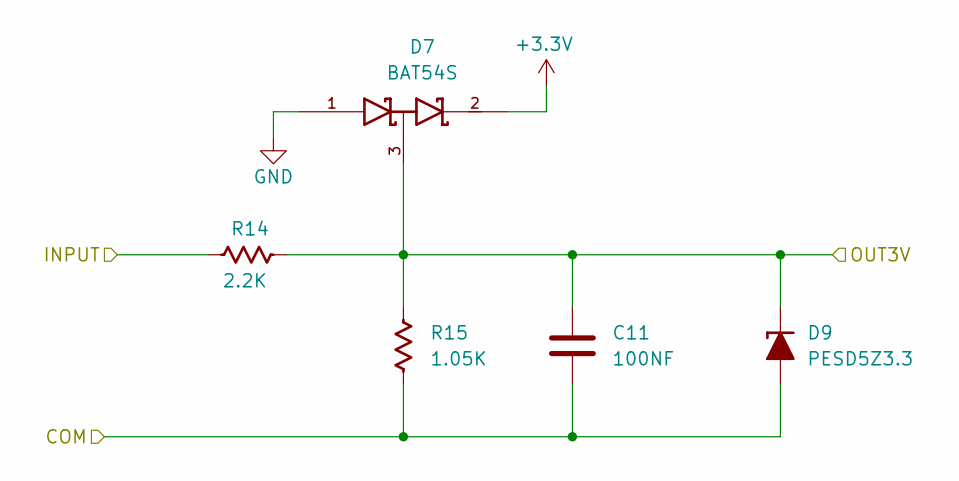
[picture p40: schematic IN-0-10V.kicad_sch]

Parts:
C11: 100NF; C_0603_1608Metric
D7: BAT54S; SOT23-3_PO132; Part Number BAT54S-7-F; JLCPCB ID C83574
D9: PESD5Z3.3; D_SOD-523
R14: 2.2K; R_0603_1608Metric
R15: 1.05K; R_0603_1608Metric

Connections:
+3.3V: D7.2 (cathode); also elsewhere on the board
/control/CON_IN_0-10V_1: R14.1; also elsewhere on the board
/control/IN-0-10V/COM: C11.2, D9.2 (A), R15.2
/control/IN-0-10V/OUT3V: C11.1, D7.3 (AK), D9.1 (K), R14.2, R15.1; also elsewhere on the board
GND: D7.1 (Anode); also elsewhere on the board

Parts of its further copies:
C32: 100NF; C_0603_1608Metric
D13: BAT54S; SOT23-3_PO132; Part Number BAT54S-7-F; JLCPCB ID C83574
D14: PESD5Z3.3; D_SOD-523
R44: 2.2K; R_0603_1608Metric
R45: 1.05K; R_0603_1608Metric

Connections of its further copies:
+3.3V: D13.2 (cathode); also elsewhere on the board
/control/CON_IN_0-10V_2: R44.1; also elsewhere on the board
/control/IN-0-10V1/COM: C32.2, D14.2 (A), R45.2
/control/IN-0-10V1/OUT3V: C32.1, D13.3 (AK), D14.1 (K), R44.2, R45.1; also elsewhere on the board
GND: D13.1 (Anode); also elsewhere on the board

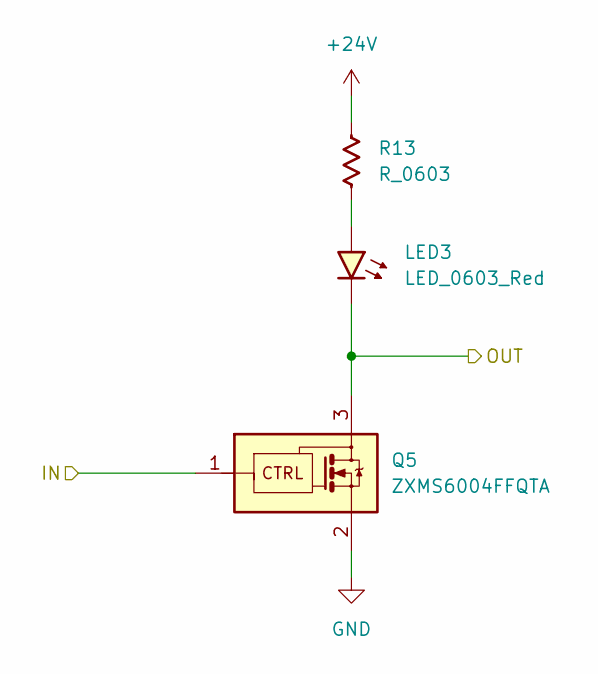
[picture p41: schematic OUT-NPN.kicad_sch]

Parts:
LED3: LED_0603_Red; LED_0603_1608Metric
Q5: ZXMS6004FFQTA; SOT-23-3; Part Number ZXMS6004FFQTA
R13: R_0603; R_0603_1608Metric

Connections:
+24V: R13.1; also elsewhere on the board
/control/CON_OUT_NPN1: LED3.1 (K), Q5.3 (D); also elsewhere on the board
/control/OUT_NPN1: Q5.1 (IN); also elsewhere on the board
GND: Q5.2 (OUT); also elsewhere on the board
unnamed: LED3.2 (A), R13.2

Parts of its further copies:
LED1, LED2, LED4: LED_0603_Red; LED_0603_1608Metric
Q2, Q3, Q4: ZXMS6004FFQTA; SOT-23-3; Part Number ZXMS6004FFQTA
R32, R33, R34: R_0603; R_0603_1608Metric

Connections of its further copies:
+24V: R32.1, R33.1, R34.1; also elsewhere on the board
/control/CON_OUT_NPN2: LED1.1 (K), Q2.3 (D); also elsewhere on the board
/control/CON_OUT_NPN3: LED2.1 (K), Q3.3 (D); also elsewhere on the board
/control/CON_OUT_NPN4: LED4.1 (K), Q4.3 (D); also elsewhere on the board
/control/OUT_NPN2: Q2.1 (IN); also elsewhere on the board
/control/OUT_NPN3: Q3.1 (IN); also elsewhere on the board
/control/OUT_NPN4: Q4.1 (IN); also elsewhere on the board
GND: Q2.2 (OUT), Q3.2 (OUT), Q4.2 (OUT); also elsewhere on the board
unnamed: LED1.2 (A), R32.2
unnamed: LED2.2 (A), R33.2
unnamed: LED4.2 (A), R34.2

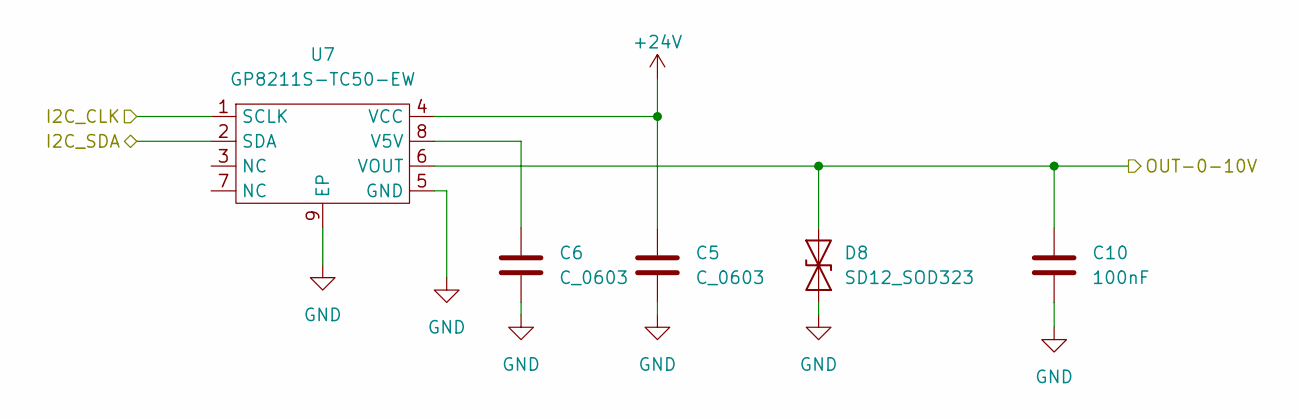
[picture p42: schematic OUT-0-10V.kicad_sch]

Parts:
C5, C6: C_0603; C_0603_1608Metric
C10: 100nF; C_0603_1608Metric
D8: SD12_SOD323; D_SOD-323
U7: GP8211S-TC50-EW; ESOP-8_L4.9-W3.9-P1.27-LS6.0-BL-EP; LCSC Part C3152008

Connections:
+24V: C5.1, U7.4 (VCC); also elsewhere on the board
/control/CON_OUT_0-10V: C10.1, D8.2 (A2), U7.6 (VOUT); also elsewhere on the board
/control/i2c_scl: U7.1 (SCLK); also elsewhere on the board
/control/i2c_sda: U7.2 (SDA); also elsewhere on the board
GND: C5.2, C6.2, C10.2, D8.1 (A1), U7.5 (GND), U7.9 (EP); also elsewhere on the board
unnamed: C6.1, U7.8 (V5V)

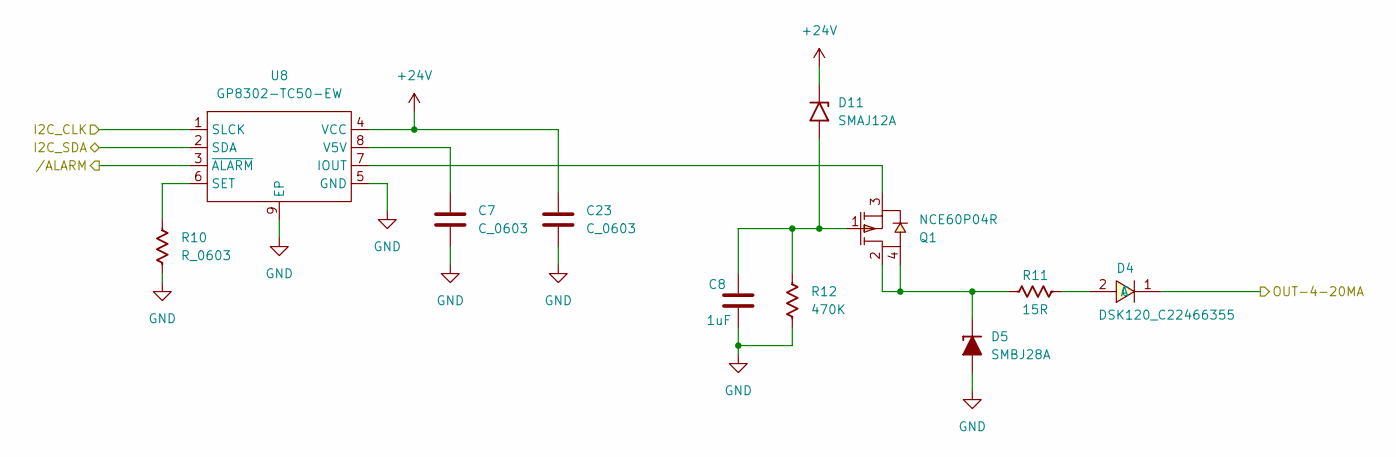
[picture p43: schematic OUT-4-20MA.kicad_sch]

Parts:
C7, C23: C_0603; C_0603_1608Metric
C8: 1uF; C_0603_1608Metric
D4: DSK120_C22466355; SOD-123FL_L2.7-W1.8-LS3.8-RD; LCSC Part C22466355
D5: SMBJ28A; D_SMB
D11: SMAJ12A; D_SMA
Q1: NCE60P04R; SOT-223-3_L6.5-W3.4-P2.30-LS7.0-BR; LCSC Part C502855
R10: R_0603; R_0603_1608Metric
R11: 15R; R_0805_2012Metric
R12: 470K; R_0603_1608Metric
U8: GP8302-TC50-EW; ESOP-8_L4.9-W3.9-P1.27-LS6.0-BL-EP; LCSC Part C2856295

Connections:
+24V: C23.1, D11.1 (A1), U8.4 (VCC); also elsewhere on the board
/control/CON_OUT_4-20MA: D4.1 (C); also elsewhere on the board
/control/OUT-4-20MA//ALARM: U8.3 (~ALARM)
/control/i2c_scl: U8.1 (SLCK); also elsewhere on the board
/control/i2c_sda: U8.2 (SDA); also elsewhere on the board
GND: C7.2, C8.2, C23.2, D5.2 (A), R10.2, R12.2, U8.5 (GND), U8.9 (EP); also elsewhere on the board
unnamed: D4.2 (A), R11.2
unnamed: D5.1 (K), Q1.2, Q1.4, R11.1
unnamed: C8.1, D11.2 (A2), Q1.1, R12.1
unnamed: Q1.3, U8.7 (IOUT)
unnamed: R10.1, U8.6 (SET)
unnamed: C7.1, U8.8 (V5V)

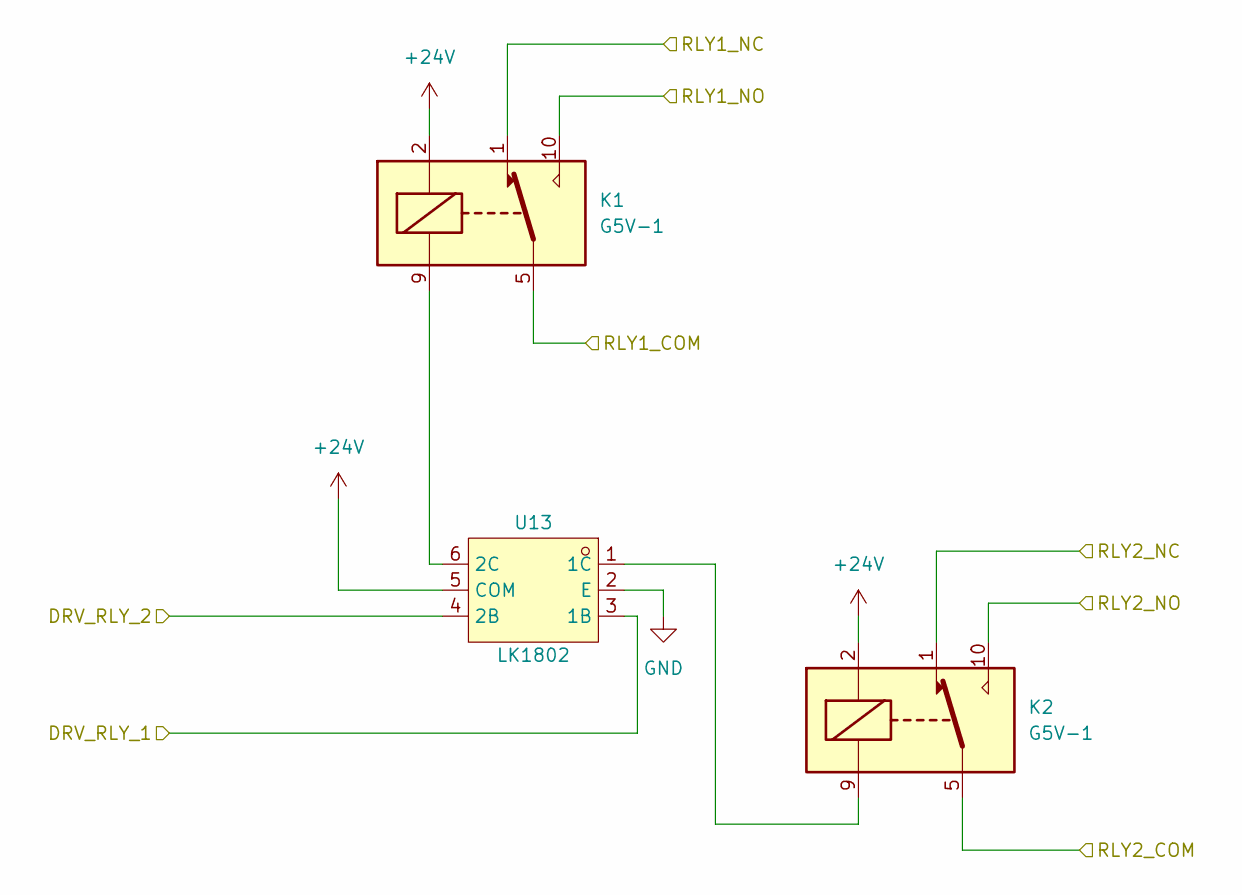
[picture p44: schematic RLY.kicad_sch]

Parts:
K1, K2: G5V-1; Relay_SPDT_Omron_G5V-1
U13: LK1802; SOT-23-6_L2.9-W1.6-P0.95-LS2.8-BR; LCSC Part C2984831

Connections:
+24V: K1.2, K2.2, U13.5 (COM); also elsewhere on the board
/control/CON_OUT_RLY1_COM: K1.5, K1.6; also elsewhere on the board
/control/CON_OUT_RLY1_NC: K1.1; also elsewhere on the board
/control/CON_OUT_RLY1_NO: K1.10; also elsewhere on the board
/control/CON_OUT_RLY2_COM: K2.5, K2.6; also elsewhere on the board
/control/CON_OUT_RLY2_NC: K2.1; also elsewhere on the board
/control/CON_OUT_RLY2_NO: K2.10; also elsewhere on the board
/control/OUT_RLY1: U13.3 (1B); also elsewhere on the board
/control/OUT_RLY2: U13.4 (2B); also elsewhere on the board
GND: U13.2 (E); also elsewhere on the board
unnamed: K2.9, U13.1 (1C)
unnamed: K1.9, U13.6 (2C)
