HarlinFrancisco/Harlin_Francisco_Electiva_2026_C1/(commit log)

2026-02-17 Subiendo carpeta llamada PLC nizao
    [PLC_nizao.FCStd, Tapa inferior PLC_Nizao.FCStd]
2026-03-19 + Subiendo Archivos de diseño y circuito
    [PLC_nizao.FCStd, Tapa inferior PLC_Nizao.FCStd]
2026-03-19 Actualizando repositorio
    [EnergyMeterA1.kicad_sch, IN-0-10V.kicad_sch, IN-4-20MA.kicad_sch, IN-DI.kicad_sch, IN-NPN-OPTO.kicad_sch, IN-PNP-OPTO.kicad_sch, IN_NPN.kicad_sch, OUT-0-10V.kicad_sch]
